lifewatch-at/LifeWatch-PCBs/LifeWatch_CO2/LifeWatch_CO2.step

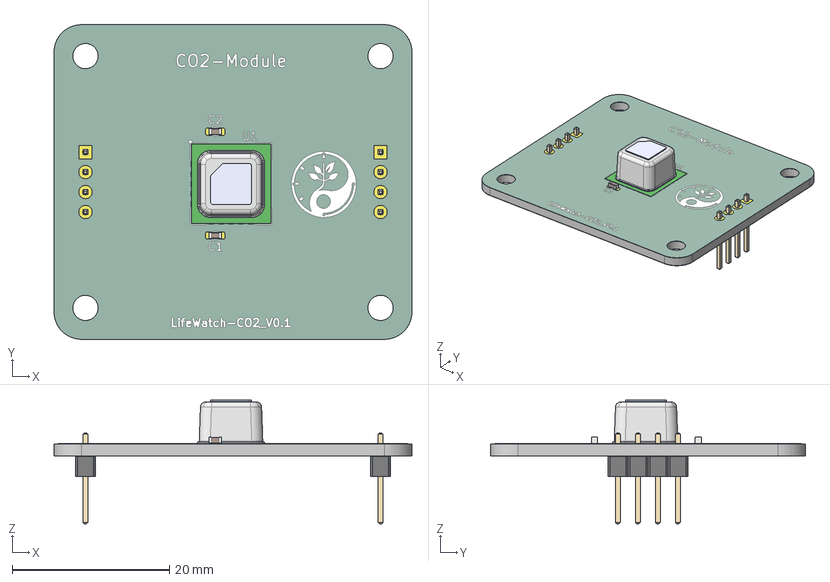
[picture p1: CAD file, 2025-07-20]
LifeWatch_CO2/LifeWatch_CO2.step
45.5 x 40.0 x 15.7 mm
C_0603_1608Metric x 2
Sensirion_CO2_Sensors_SCD4x_STEP_file
PinHeader_1x04_P2.54mm_Vertical x 2
LifeWatch_CO2_copper
LifeWatch_CO2_silkscreen
LifeWatch_CO2_soldermask
LifeWatch_CO2_PCB
