lifewatch-at/LifeWatch-PCBs/LifeWatch_MB/LifeWatch_MB.kicad_pcb

## KiCad design LifeWatch_MB/LifeWatch_MB.kicad_pcb (2025-07-20)

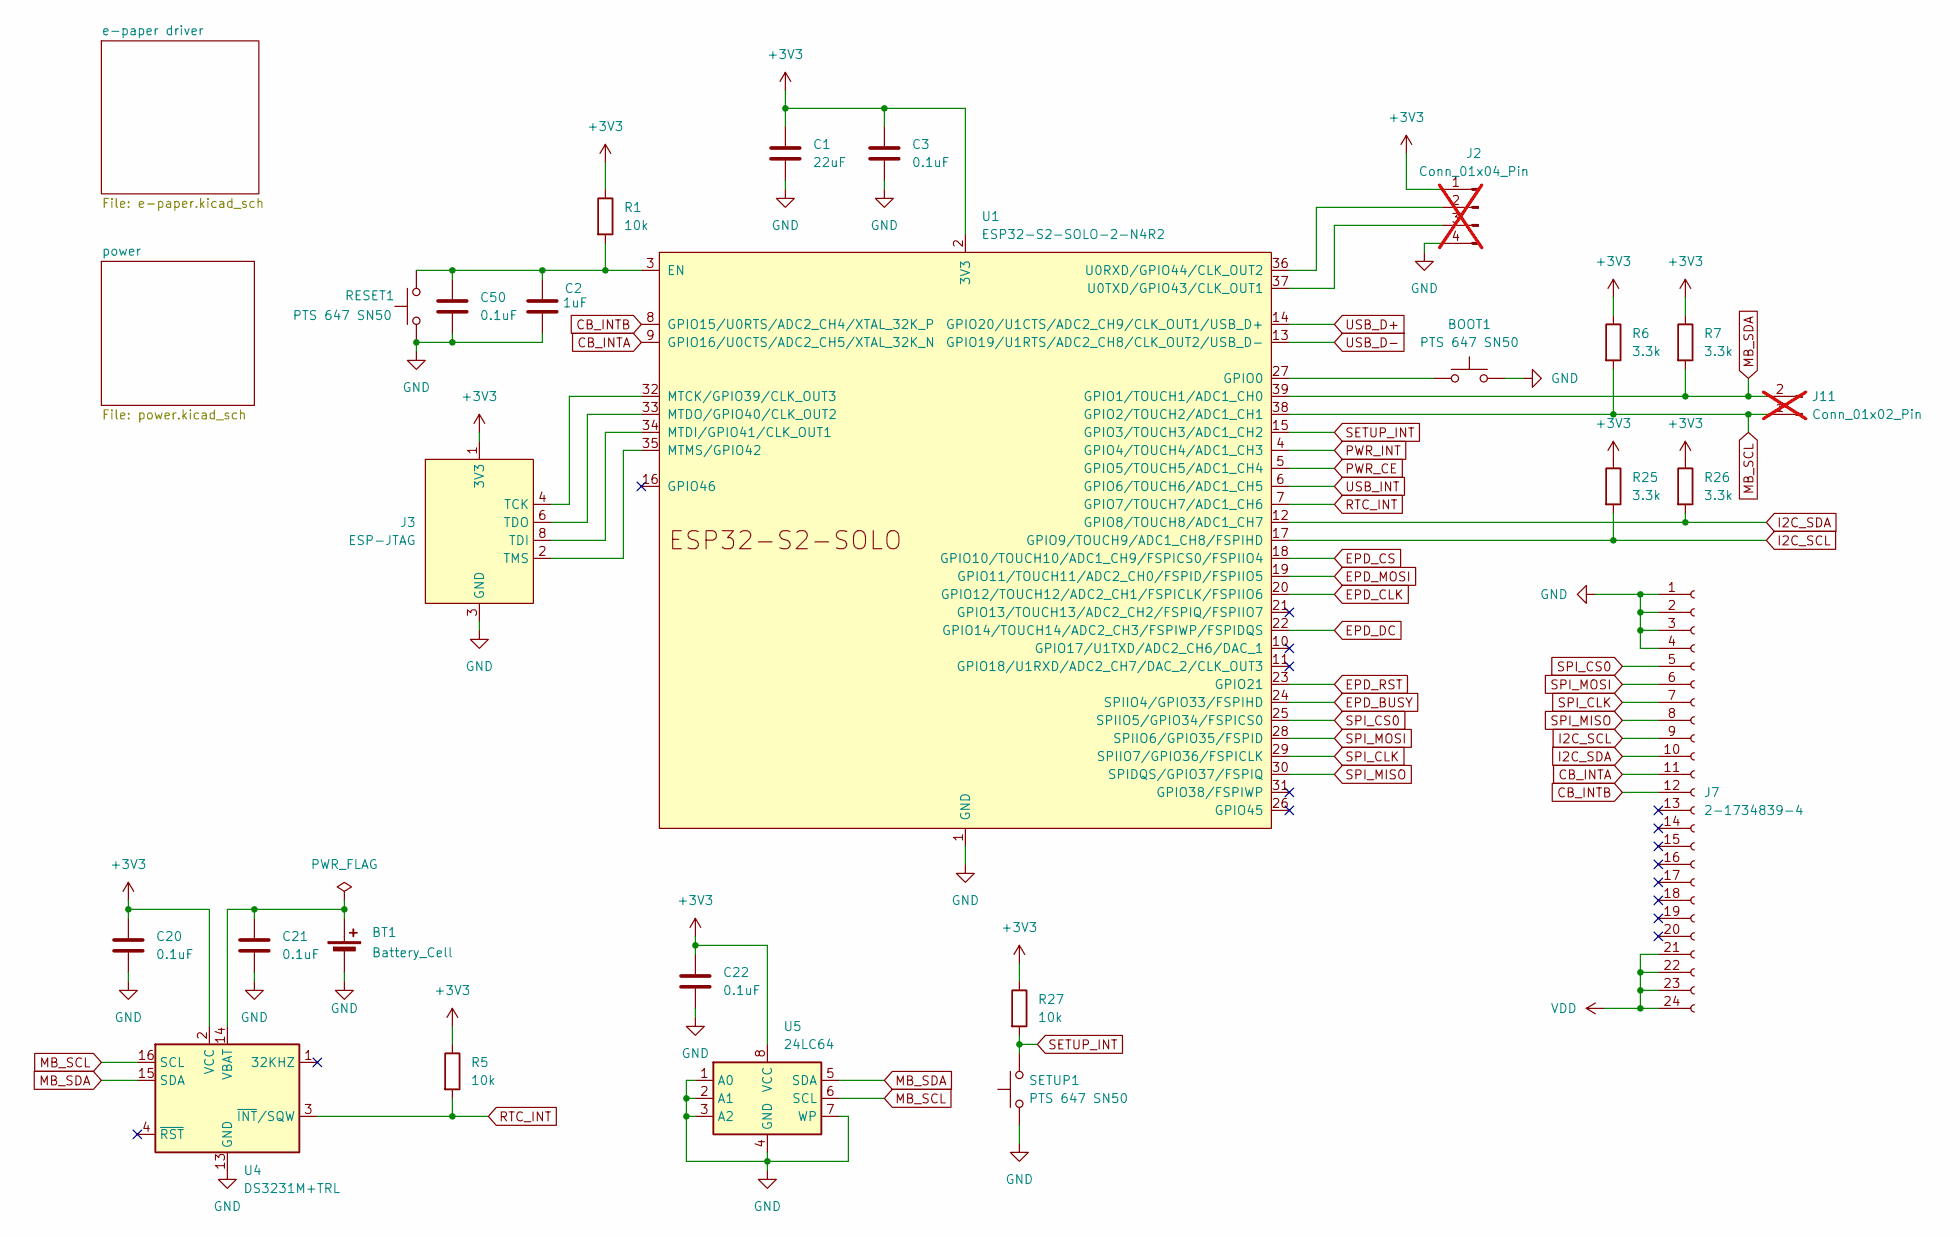
[picture p2: schematic LifeWatch_MB.kicad_sch, LifeWatch Mainboard]

Parts:
BOOT1: PTS 647 SN50; SW_SPST_PTS647_Sx50; Manufacturer_Part_Number PTS 647 SN50 SMTR2 LFS
BT1: Battery_Cell; BatteryHolder_Keystone_1060_1x2032; Manufacturer_Part_Number Keystone 3034
C1: 22uF; C_0805_2012Metric; Manufacturer_Part_Number CL21A226MQQNNNE
C2: 1uF; C_0603_1608Metric; Manufacturer_Part_Number CC0603KRX7R7BB105
C3, C20, C21, C22, C50: 0.1uF; C_0402_1005Metric; Manufacturer_Part_Number CL05B104KP5NNNC
J2: Conn_01x04_Pin; PinHeader_1x04_P2.54mm_Vertical; not fitted
J3: ESP-JTAG; IDC-Header_2x05_P2.54mm_Vertical
J7: 2-1734839-4; TE_2-1734839-4_1x24-1MP_P0.5mm_Horizontal; Manufacturer_Part_Number 2-1734839-4
J11: Conn_01x02_Pin; PinHeader_1x02_P2.54mm_Vertical; not fitted
R1, R5, R27: 10k; R_0805_2012Metric; Manufacturer_Part_Number RC0805FR-0710KL
R6, R7, R25, R26: 3.3k; R_0805_2012Metric; Manufacturer_Part_Number RC0805FR-073K3L
RESET1: PTS 647 SN50; SW_SPST_PTS647_Sx50; Manufacturer_Part_Number PTS 647 SN50 SMTR2 LFS
SETUP1: PTS 647 SN50; SW_SPST_PTS647_Sx50; Manufacturer_Part_Number PTS 647 SN50 SMTR2 LFS
U1: ESP32-S2-SOLO-2-N4R2; ESP32-S2-SOLO; Manufacturer_Part_Number ESP32-S2-SOLO-2-N4R2
U4: DS3231M+TRL; SOIC-16W_7.5x10.3mm_P1.27mm; Manufacturer_Part_Number DS3231M+TRL
U5: 24LC64; SOIC-8_3.9x4.9mm_P1.27mm; Manufacturer_Part_Number 24LC64T-I/SN

Connections:
+3V3: C1.1, C3.1, C20.1, C22.1, J2.1, J3.1 (3V3), R1.1, R5.1, R6.1, R7.1, R25.1, R26.1, R27.1, U1.2 (3V3), U4.2 (VCC), U5.8 (VCC); also elsewhere on the board
CB_INTA: J7.11, U1.9 (GPIO16/U0CTS/ADC2_CH5/XTAL_32K_N)
CB_INTB: J7.12, U1.8 (GPIO15/U0RTS/ADC2_CH4/XTAL_32K_P)
EPD_BUSY: U1.24 (SPIIO4/GPIO33/FSPIHD); also elsewhere on the board
EPD_CLK: U1.20 (GPIO12/TOUCH12/ADC2_CH1/FSPICLK/FSPIIO6); also elsewhere on the board
EPD_CS: U1.18 (GPIO10/TOUCH10/ADC1_CH9/FSPICS0/FSPIIO4); also elsewhere on the board
EPD_DC: U1.22 (GPIO14/TOUCH14/ADC2_CH3/FSPIWP/FSPIDQS); also elsewhere on the board
EPD_MOSI: U1.19 (GPIO11/TOUCH11/ADC2_CH0/FSPID/FSPIIO5); also elsewhere on the board
EPD_RST: U1.23 (GPIO21); also elsewhere on the board
GND: BOOT1.2, BT1.2 (-), C1.2, C2.2, C3.2, C20.2, C21.2, C22.2, C50.2, J2.4, J3.3 (GND), J3.5 (GND), J3.7 (GND), J3.9 (GND), J7.1, J7.2, J7.3, J7.4, RESET1.1, SETUP1.1, U1.1 (GND), U1.40 (GND), U1.41 (GND), U4.5 (GND), U4.6 (GND), U4.7 (GND), U4.8 (GND), U4.9 (GND), U4.10 (GND), U4.11 (GND), U4.12 (GND), U4.13 (GND), U5.1 (A0), U5.2 (A1), U5.3 (A2), U5.4 (GND), U5.7 (WP); also elsewhere on the board
I2C_SCL: J7.9, R25.2, U1.17 (GPIO9/TOUCH9/ADC1_CH8/FSPIHD)
I2C_SDA: J7.10, R26.2, U1.12 (GPIO8/TOUCH8/ADC1_CH7)
MB_SCL: J11.1, R6.2, U1.38 (GPIO2/TOUCH2/ADC1_CH1), U4.16 (SCL), U5.6 (SCL); also elsewhere on the board
MB_SDA: J11.2, R7.2, U1.39 (GPIO1/TOUCH1/ADC1_CH0), U4.15 (SDA), U5.5 (SDA); also elsewhere on the board
unnamed: BT1.1 (+), C21.1, U4.14 (VBAT)
unnamed: J2.2, U1.36 (U0RXD/GPIO44/CLK_OUT2)
unnamed: J2.3, U1.37 (U0TXD/GPIO43/CLK_OUT1)
unnamed: J3.4 (TCK), U1.32 (MTCK/GPIO39/CLK_OUT3)
unnamed: J3.8 (TDI), U1.34 (MTDI/GPIO41/CLK_OUT1)
unnamed: J3.6 (TDO), U1.33 (MTDO/GPIO40/CLK_OUT2)
unnamed: J3.2 (TMS), U1.35 (MTMS/GPIO42)
unnamed: C2.1, C50.1, R1.2, RESET1.2, U1.3 (EN)
unnamed: BOOT1.1, U1.27 (GPIO0)
PWR_CE: U1.5 (GPIO5/TOUCH5/ADC1_CH4); also elsewhere on the board
PWR_INT: U1.4 (GPIO4/TOUCH4/ADC1_CH3); also elsewhere on the board
RTC_INT: R5.2, U1.7 (GPIO7/TOUCH7/ADC1_CH6), U4.3 (~INT/SQW)
SETUP_INT: R27.2, SETUP1.2, U1.15 (GPIO3/TOUCH3/ADC1_CH2)
SPI_CLK: J7.7, U1.29 (SPIIO7/GPIO36/FSPICLK)
SPI_CS0: J7.5, U1.25 (SPIIO5/GPIO34/FSPICS0)
SPI_MISO: J7.8, U1.30 (SPIDQS/GPIO37/FSPIQ)
SPI_MOSI: J7.6, U1.28 (SPIIO6/GPIO35/FSPID)
USB_D+: U1.14 (GPIO20/U1CTS/ADC2_CH9/CLK_OUT1/USB_D+); also elsewhere on the board
USB_D-: U1.13 (GPIO19/U1RTS/ADC2_CH8/CLK_OUT2/USB_D-); also elsewhere on the board
USB_INT: U1.6 (GPIO6/TOUCH6/ADC1_CH5); also elsewhere on the board
VDD: J7.21, J7.22, J7.23, J7.24; also elsewhere on the board

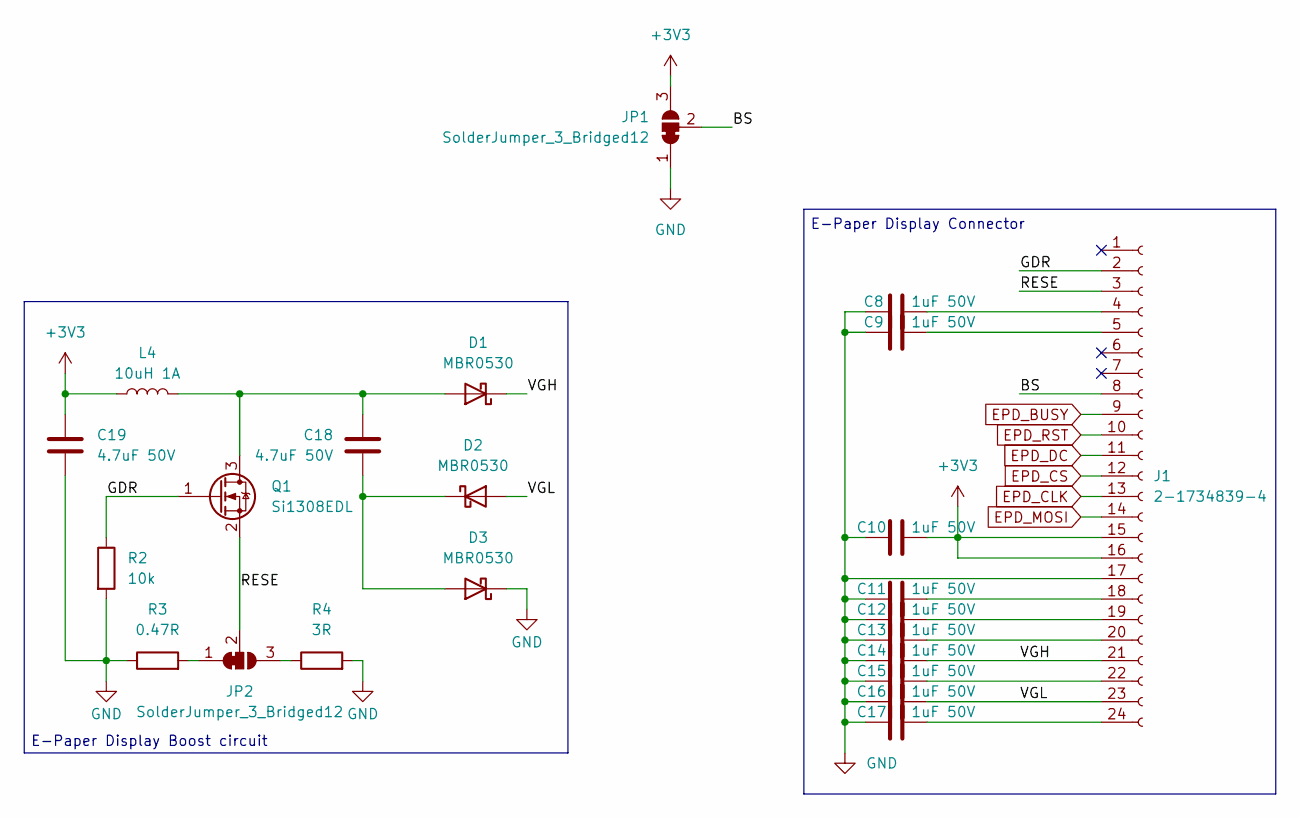
[picture p3: schematic e-paper.kicad_sch, e-paper driver]

Parts:
C8, C9, C10, C11, C12, C13, C14, C15, C16, C17: 1uF 50V; C_0805_2012Metric; Manufacturer_Part_Number CL21B105KBFNNNE
C18, C19: 4.7uF 50V; C_0805_2012Metric; Manufacturer_Part_Number GRM21BR61H475KE51L
D1, D2, D3: MBR0530; D_SOD-123; Manufacturer_Part_Number MBR0530T1G
J1: 2-1734839-4; TE_2-1734839-4_1x24-1MP_P0.5mm_Horizontal; Manufacturer_Part_Number 2-1734839-4
JP1, JP2: SolderJumper_3_Bridged12; SolderJumper-3_P1.3mm_Bridged12_RoundedPad1.0x1.5mm
L4: 10uH 1A; L_Vishay_IHLP-2525; Manufacturer_Part_Number IHLP2525CZER100M01
Q1: Si1308EDL; SOT-323_SC-70; Manufacturer_Part_Number SI1308EDL-T1-GE3
R2: 10k; R_0805_2012Metric; Manufacturer_Part_Number RC0805FR-0710KL
R3: 0.47R; R_0805_2012Metric; Manufacturer_Part_Number ERJ-6RQFR47V
R4: 3R; R_0805_2012Metric; Manufacturer_Part_Number RC0805FR-073RL

Connections:
+3V3: C10.2, C19.1, J1.15, J1.16, JP1.3 (B), L4.1; also elsewhere on the board
/e-paper driver/BS: J1.8, JP1.2 (C)
/e-paper driver/GDR: J1.2, Q1.1 (G), R2.1
/e-paper driver/RESE: J1.3, JP2.2 (C), Q1.2 (S)
/e-paper driver/VGH: C14.2, D1.1 (K), J1.21
/e-paper driver/VGL: C16.2, D2.2 (A), J1.23
EPD_BUSY: J1.9; also elsewhere on the board
EPD_CLK: J1.13; also elsewhere on the board
EPD_CS: J1.12; also elsewhere on the board
EPD_DC: J1.11; also elsewhere on the board
EPD_MOSI: J1.14; also elsewhere on the board
EPD_RST: J1.10; also elsewhere on the board
GND: C8.1, C9.1, C10.1, C11.1, C12.1, C13.1, C14.1, C15.1, C16.1, C17.1, C19.2, D3.1 (K), J1.17, JP1.1 (A), R2.2, R3.1, R4.2; also elsewhere on the board
unnamed: C18.1, D1.2 (A), L4.2, Q1.3 (D)
unnamed: C18.2, D2.1 (K), D3.2 (A)
unnamed: C8.2, J1.4
unnamed: C9.2, J1.5
unnamed: C11.2, J1.18
unnamed: C12.2, J1.19
unnamed: C13.2, J1.20
unnamed: C15.2, J1.22
unnamed: C17.2, J1.24
unnamed: JP2.1 (A), R3.2
unnamed: JP2.3 (B), R4.1

Notes on the sheet:
E-Paper Display Connector
E-Paper Display Boost circuit

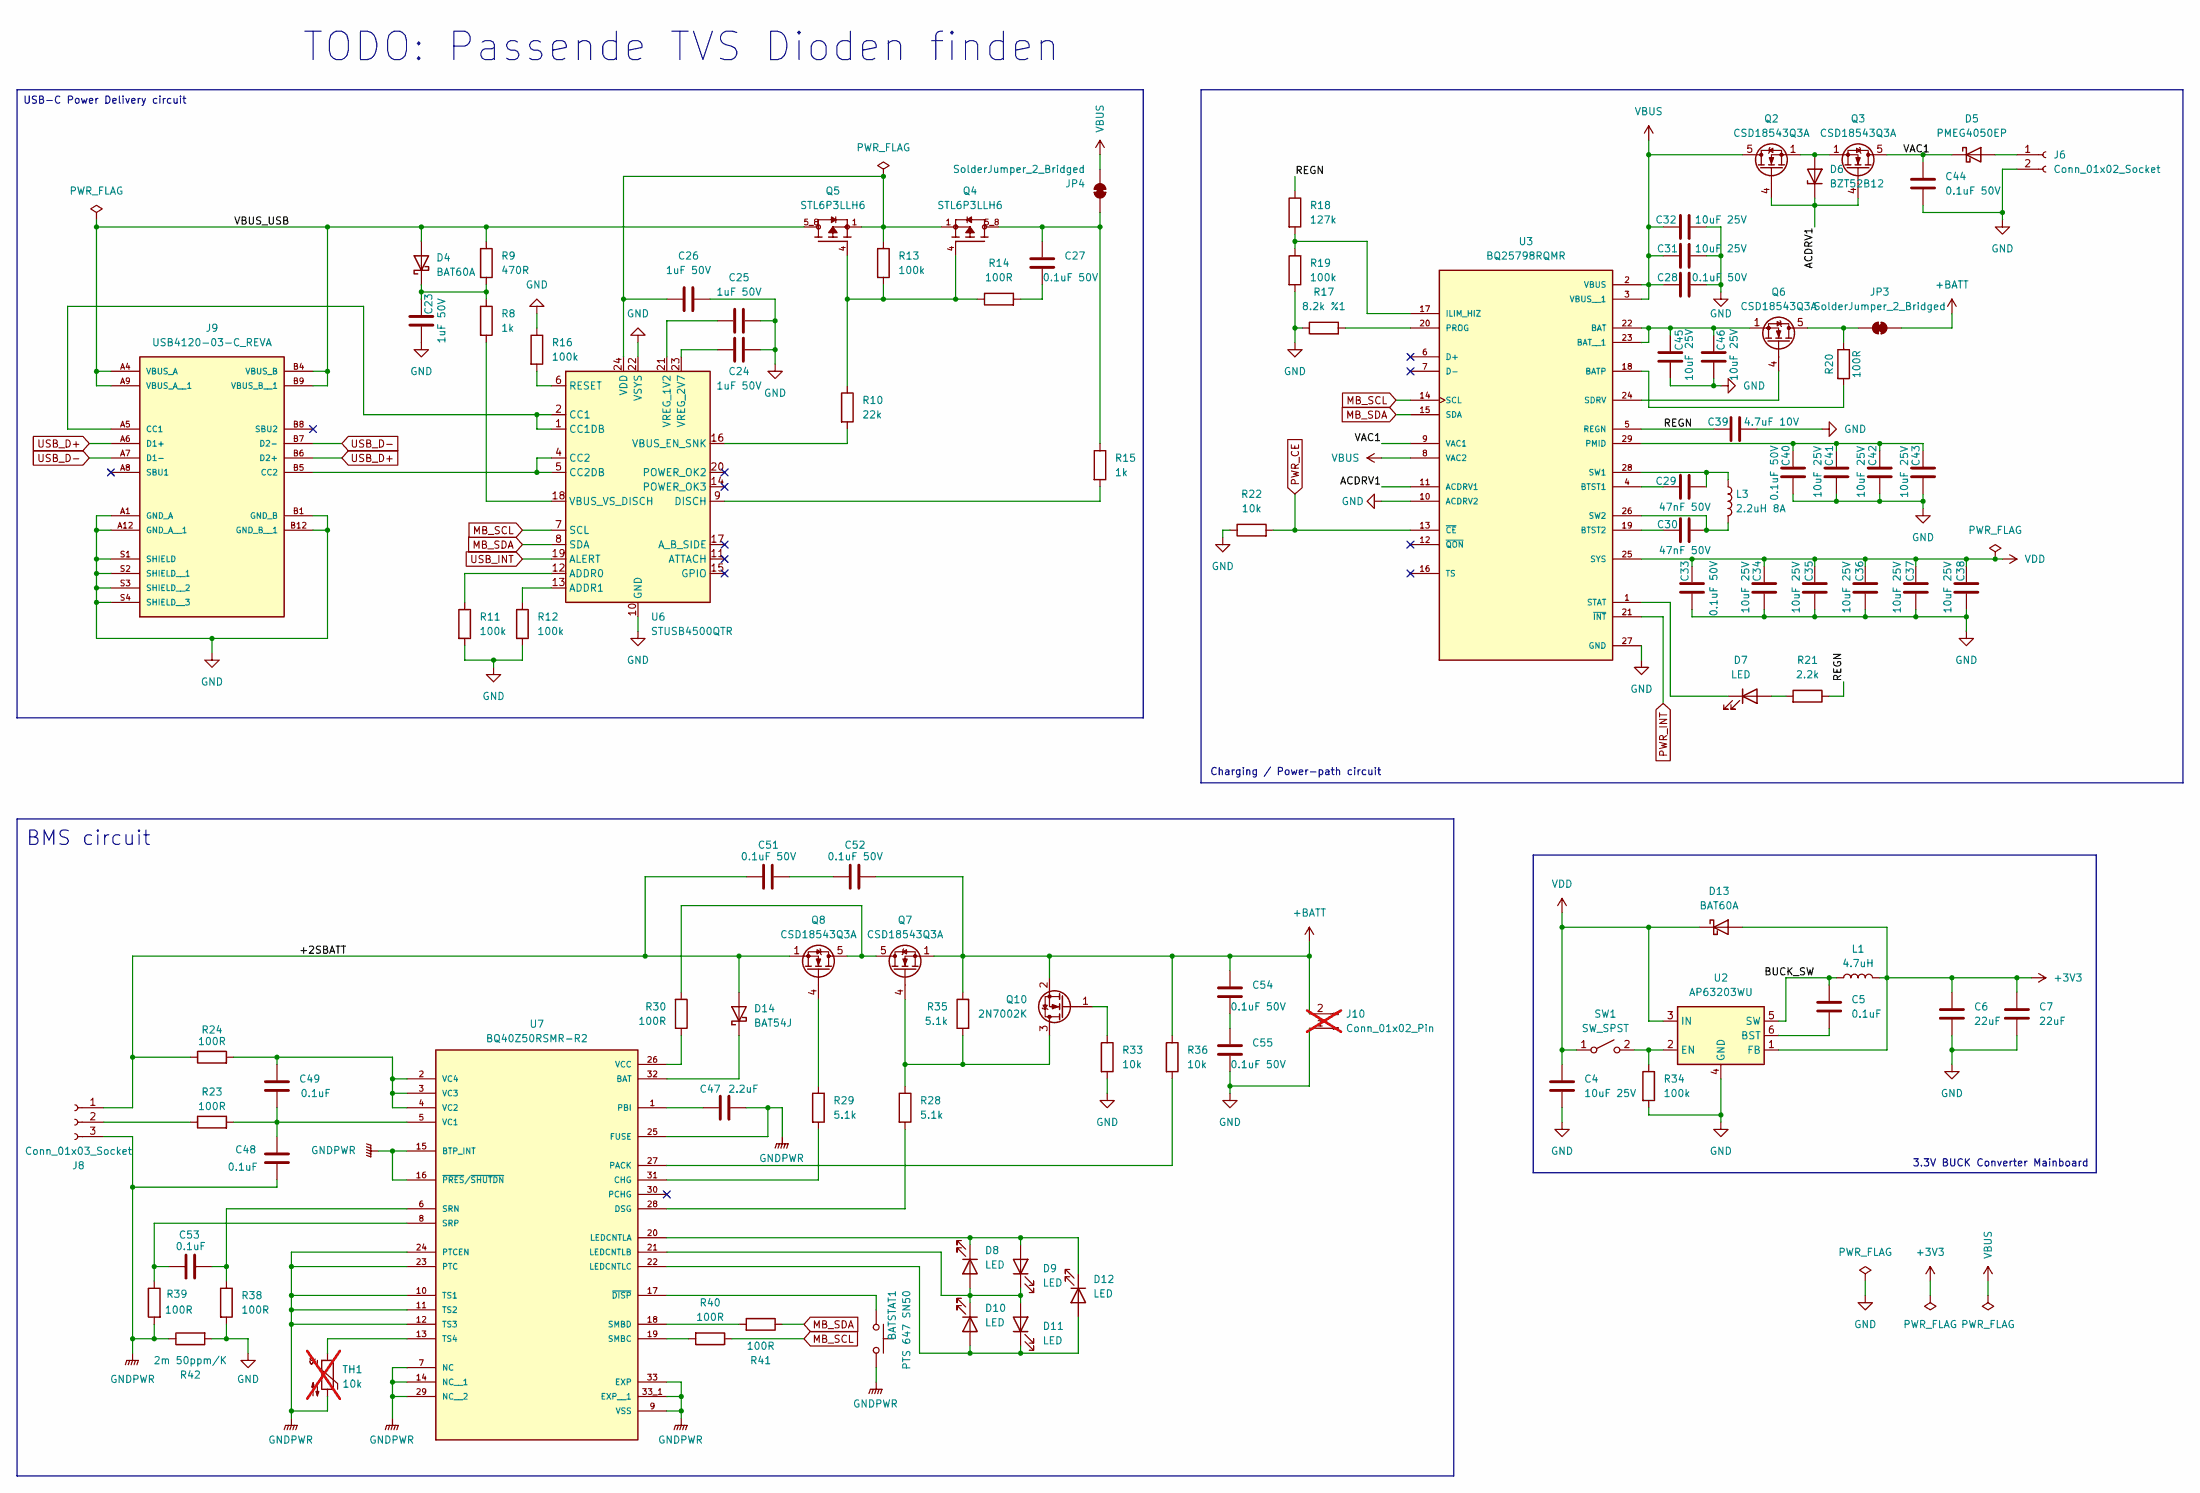
[picture p4: schematic power.kicad_sch]

Parts:
BATSTAT1: PTS 647 SN50; SW_SPST_PTS647_Sx50; Manufacturer_Part_Number PTS 647 SN50 SMTR2 LFS
C4, C31, C32, C34, C35, C36, C37, C38, C41, C42, C43, C45, C46: 10uF 25V; C_0805_2012Metric; Manufacturer_Part_Number GRM21BR61E106KA73L
C5, C48, C49, C53: 0.1uF; C_0402_1005Metric; Manufacturer_Part_Number CL05B104KP5NNNC
C6, C7: 22uF; C_0805_2012Metric; Manufacturer_Part_Number CL21A226MQQNNNE
C23, C24, C25, C26: 1uF 50V; C_0805_2012Metric; Manufacturer_Part_Number CL21B105KBFNNNE
C27, C28, C33, C40, C44, C51, C52, C54, C55: 0.1uF 50V; C_0402_1005Metric; Manufacturer_Part_Number GRM155R71H104KE14D
C29, C30: 47nF 50V; C_0402_1005Metric; Manufacturer_Part_Number CGA2B3X7R1H473K050BB
C39: 4.7uF 10V; C_0603_1608Metric; Manufacturer_Part_Number CL10A475KP8NNNC
C47: 2.2uF; C_0603_1608Metric; Manufacturer_Part_Number GRM188R71A225KE15D
D4, D13: BAT60A; D_SOD-323; Manufacturer_Part_Number BAT60AE6327HTSA1
D5: PMEG4050EP; D_SOD-128; Manufacturer_Part_Number PMEG4050EP,115
D6: BZT52B12; D_SOD-123F; Manufacturer_Part_Number BZT52C12-7-F
D7: LED; LED_D3.0mm; Manufacturer_Part_Number 150060RS75000
D8, D9, D10, D11, D12: LED; LED_0603_1608Metric; Manufacturer_Part_Number 150060RS75000
D14: BAT54J; D_SOD-323F; Manufacturer_Part_Number BAT54J,115
J6: Conn_01x02_Socket; PhoenixContact_MCV_1,5_2-GF-3.5_1x02_P3.50mm_Vertical_Threa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; Manufacturer_Part_Number 1843224
J8: Conn_01x03_Socket; JST_XH_B3B-XH-A_1x03_P2.50mm_Vertical; Manufacturer_Part_Number B3B-XH-A
J9: USB4120-03-C_REVA; GCT_USB4120-03-C_REVA; PARTREV A
J10: Conn_01x02_Pin; PinHeader_1x02_P2.54mm_Vertical; not fitted
JP3, JP4: SolderJumper_2_Bridged; SolderJumper-2_P1.3mm_Bridged_RoundedPad1.0x1.5mm
L1: 4.7uH; L_Vishay_IHLP-2525; Manufacturer_Part_Number IHLP2525CZER4R7M01
L3: 2.2uH 8A; L_Vishay_IHLP-2525; Manufacturer_Part_Number IHLP2525CZER2R2M01
Q2, Q3, Q6, Q7, Q8: CSD18543Q3A; VSON-8_3.3x3.3mm_P0.65mm_NexFET; Manufacturer_Part_Number CSD18543Q3A
Q4, Q5: STL6P3LLH6; TRANS_STL6P3LLH6; PARTREV 4
Q10: 2N7002K; SOT-23; Manufacturer_Part_Number 2N7002K
R8, R15: 1k; R_0805_2012Metric; Manufacturer_Part_Number RC0805FR-071KL
R9: 470R; R_0805_2012Metric; Manufacturer_Part_Number RC0805FR-07470RL
R10: 22k; R_0805_2012Metric; Manufacturer_Part_Number RC0805FR-0722KL
R11, R12, R13, R16, R19, R34: 100k; R_0805_2012Metric; Manufacturer_Part_Number RC0805FR-07100KL
R14, R20, R23, R24, R30, R38, R39, R40, R41: 100R; R_0805_2012Metric; Manufacturer_Part_Number RC0805FR-07100RL
R17: 8.2k %1; R_0805_2012Metric; Manufacturer_Part_Number RC0805FR-078K2L
R18: 127k; R_0805_2012Metric; Manufacturer_Part_Number RC0805FR-07127KL
R21: 2.2k; R_0805_2012Metric; Manufacturer_Part_Number RC0805FR-072K2L
R22, R33, R36: 10k; R_0805_2012Metric; Manufacturer_Part_Number RC0805FR-0710KL
R28, R29, R35: 5.1k; R_0805_2012Metric; Manufacturer_Part_Number RC0805FR-075K1L
R42: 2m 50ppm/K; R_2512_6332Metric_Pad1.40x3.35mm_HandSolder; Manufacturer_Part_Number BVT-I-R002-1.0
SW1: SW_SPST; PinHeader_1x02_P2.54mm_Horizontal
TH1: 10k; PinHeader_1x02_P2.54mm_Vertical; not fitted
U2: AP63203WU; TSOT-23-6; Manufacturer_Part_Number AP63203WU-7
U3: BQ25798RQMR; QFN40P400X400X100-29N; PARTREV 11/2019
U6: STUSB4500QTR; QFN-24-1EP_4x4mm_P0.5mm_EP2.7x2.7mm; Manufacturer_Part_Number STUSB4500QTR
U7: BQ40Z50RSMR-R2; QFN40P400X400X100-33N; PARTREV B

Connections:
+3V3: C6.1, C7.1, D13.2 (A), L1.2, U2.1 (FB); also elsewhere on the board
+BATT: C52.2, C54.1, J10.2, JP3.2 (B), Q7.1 (S), Q7.2 (S), Q7.3 (S), Q10.2 (S), R35.1, R36.1
/power/+2SBATT: C51.1, D14.2 (A), J8.1, Q8.1 (S), Q8.2 (S), Q8.3 (S), R24.1
/power/ACDRV1: D6.1 (K), Q2.4 (G), Q3.4 (G), U3.11 (ACDRV1)
/power/BUCK_SW: C5.2, L1.1, U2.5 (SW)
/power/REGN: C39.1, R18.1, R21.1, U3.5 (REGN)
/power/VAC1: C44.1, D5.1 (K), Q3.5 (D), U3.9 (VAC1)
/power/VBUS_USB: D4.2 (A), J9.A4 (VBUS_A), J9.A9 (VBUS_A__1), J9.B4 (VBUS_B), J9.B9 (VBUS_B__1), Q5.5_8, R9.1
GND: C4.2, C6.2, C7.2, C23.2, C24.2, C25.2, C26.2, C28.2, C31.2, C32.2, C33.2, C34.2, C35.2, C36.2, C37.2, C38.2, C39.2, C40.2, C41.2, C42.2, C43.2, C44.2, C45.2, C46.2, C55.2, J6.2, J9.A1 (GND_A), J9.A12 (GND_A__1), J9.B1 (GND_B), J9.B12 (GND_B__1), J9.S1 (SHIELD), J9.S2 (SHIELD__1), J9.S3 (SHIELD__2), J9.S4 (SHIELD__3), J10.1, R11.2, R12.2, R16.1, R17.1, R19.2, R22.1, R33.2, R34.2, R38.2, R42.2, U2.4 (GND), U3.10 (ACDRV2), U3.27 (GND), U6.10 (GND), U6.22 (VSYS), U6.25 (GND); also elsewhere on the board
GNDPWR: BATSTAT1.2, C47.2, C48.2, J8.3, R39.2, R42.1, TH1.2, U7.7 (NC), U7.9 (VSS), U7.10 (TS1), U7.11 (TS2), U7.12 (TS3), U7.14 (NC__1), U7.15 (BTP_INT), U7.16 (~PRES/~SHUTDN), U7.23 (PTC), U7.24 (PTCEN), U7.25 (FUSE), U7.29 (NC__2), U7.33 (EXP), U7.33_1 (EXP__1)
MB_SCL: R40.1, U3.14 (SCL), U6.7 (SCL); also elsewhere on the board
MB_SDA: R41.1, U3.15 (SDA), U6.8 (SDA); also elsewhere on the board
unnamed: C27.2, R14.2
unnamed: C51.2, C52.1
unnamed: C54.2, C55.1
unnamed: C23.1, D4.1 (K), R8.1, R9.2
unnamed: D5.2 (A), J6.1
unnamed: D6.2 (A), Q2.1 (S), Q2.2 (S), Q2.3 (S), Q3.1 (S), Q3.2 (S), Q3.3 (S)
unnamed: D7.2 (A), R21.2
unnamed: D7.1 (K), U3.1 (STAT)
unnamed: D10.2 (A), D11.1 (K), D12.2 (A), U7.22 (LEDCNTLC)
unnamed: D8.2 (A), D9.1 (K), D10.1 (K), D11.2 (A), U7.21 (LEDCNTLB)
unnamed: D8.1 (K), D9.2 (A), D12.1 (K), U7.20 (LEDCNTLA)
unnamed: D14.1 (K), U7.32 (BAT)
unnamed: J8.2, R23.1
unnamed: J9.A5 (CC1), U6.1 (CC1DB), U6.2 (CC1)
unnamed: J9.B5 (CC2), U6.4 (CC2), U6.5 (CC2DB)
unnamed: JP3.1 (A), Q6.5 (D), R20.1
unnamed: C27.1, JP4.1 (A), Q4.5_8, R15.1
unnamed: Q4.4, Q5.4, R10.1, R13.2, R14.1
unnamed: Q6.4 (G), U3.24 (SDRV)
unnamed: Q7.5 (D), Q8.5 (D), R30.2
unnamed: Q8.4 (G), R29.1
unnamed: Q7.4 (G), Q10.3 (D), R28.1, R35.2
unnamed: Q10.1 (G), R33.1
unnamed: R34.1, SW1.2 (B), U2.2 (EN)
unnamed: C5.1, U2.6 (BST)
unnamed: C45.1, C46.1, Q6.1 (S), Q6.2 (S), Q6.3 (S), U3.22 (BAT), U3.23 (BAT__1)
unnamed: R20.2, U3.18 (BATP)
unnamed: C29.1, U3.4 (BTST1)
unnamed: C30.1, U3.19 (BTST2)
unnamed: R18.2, R19.1, U3.17 (ILIM_HIZ)
unnamed: C40.1, C41.1, C42.1, C43.1, U3.29 (PMID)
unnamed: R17.2, U3.20 (PROG)
unnamed: C29.2, L3.1, U3.28 (SW1)
unnamed: C30.2, L3.2, U3.26 (SW2)
unnamed: R11.1, U6.12 (ADDR0)
unnamed: R12.1, U6.13 (ADDR1)
unnamed: R15.2, U6.9 (DISCH)
unnamed: R16.2, U6.6 (RESET)
unnamed: R10.2, U6.16 (VBUS_EN_SNK)
unnamed: R8.2, U6.18 (VBUS_VS_DISCH)
unnamed: C26.1, Q4.1, Q4.2, Q4.3, Q5.1, Q5.2, Q5.3, R13.1, U6.24 (VDD)
unnamed: C25.1, U6.21 (VREG_1V2)
unnamed: C24.1, U6.23 (VREG_2V7)
unnamed: R29.2, U7.31 (CHG)
unnamed: R28.2, U7.28 (DSG)
unnamed: R36.2, U7.27 (PACK)
unnamed: C47.1, U7.1 (PBI)
unnamed: R40.2, U7.19 (SMBC)
unnamed: R41.2, U7.18 (SMBD)
unnamed: C53.2, R38.1, U7.6 (SRN)
unnamed: C53.1, R39.1, U7.8 (SRP)
unnamed: TH1.1, U7.13 (TS4)
unnamed: C48.1, C49.2, R23.2, U7.5 (VC1)
unnamed: C49.1, R24.2, U7.2 (VC4), U7.3 (VC3), U7.4 (VC2)
unnamed: R30.1, U7.26 (VCC)
unnamed: BATSTAT1.1, U7.17 (~DISP)
PWR_CE: R22.2, U3.13 (~CE); also elsewhere on the board
PWR_INT: U3.21 (~INT); also elsewhere on the board
USB_D+: J9.A6 (D1+), J9.B6 (D2+); also elsewhere on the board
USB_D-: J9.A7 (D1-), J9.B7 (D2-); also elsewhere on the board
USB_INT: U6.19 (ALERT); also elsewhere on the board
VBUS: C28.1, C31.1, C32.1, JP4.2 (B), Q2.5 (D), U3.2 (VBUS), U3.3 (VBUS__1), U3.8 (VAC2)
VDD: C4.1, C33.1, C34.1, C35.1, C36.1, C37.1, C38.1, D13.1 (K), SW1.1 (A), U2.3 (IN), U3.25 (SYS); also elsewhere on the board

Notes on the sheet:
TODO: Passende TVS Dioden finden
USB-C Power Delivery circuit
3.3V BUCK Converter Mainboard
BMS circuit
Charging / Power-path circuit

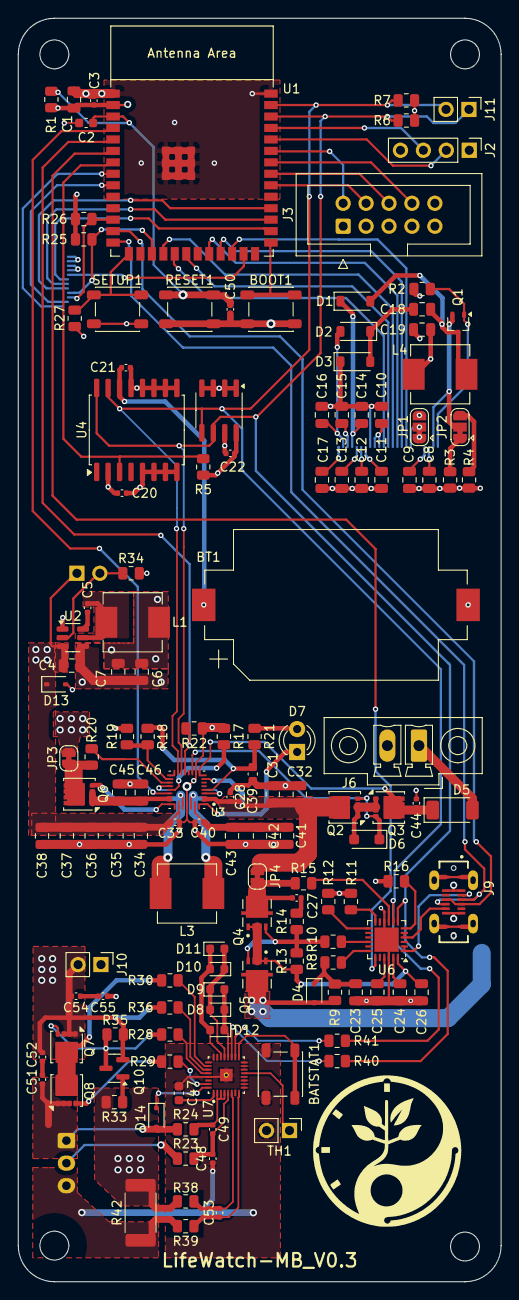
[picture p5: board LifeWatch_MB.kicad_pcb from above]

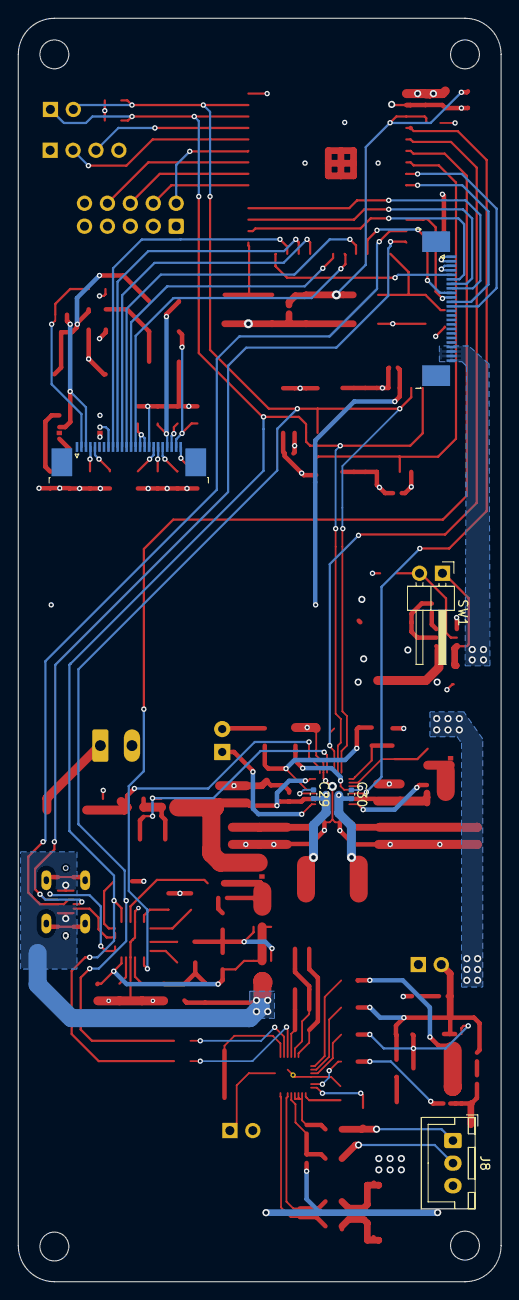
[picture p6: board LifeWatch_MB.kicad_pcb from below]

Board: 4 copper layers, 53.5 x 140.0 mm, 147 parts (6 on the bottom side), 116 nets.
