lifewatch-at/LifeWatch-PCBs/LifeWatch_Noise/LifeWatch_Noise.kicad_pcb

## KiCad design LifeWatch_Noise/LifeWatch_Noise.kicad_pcb (2025-07-20)

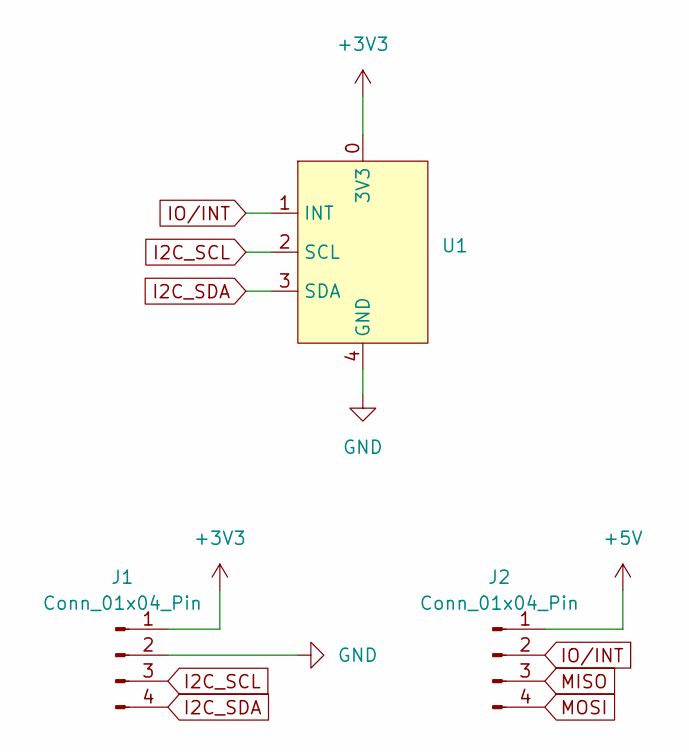
[picture p7: schematic LifeWatch_Noise.kicad_sch, LifeWatch-Noise]

Parts:
J1, J2: Conn_01x04_Pin; PinHeader_1x04_P2.54mm_Vertical
U1: i2c_decibel

Connections:
+3V3: J1.1, U1.0 (3V3)
+5V: J2.1
GND: J1.2, U1.4 (GND)
I2C_SCL: J1.3, U1.2 (SCL)
I2C_SDA: J1.4, U1.3 (SDA)
IO/INT: J2.2, U1.1 (INT)
MISO: J2.3
MOSI: J2.4

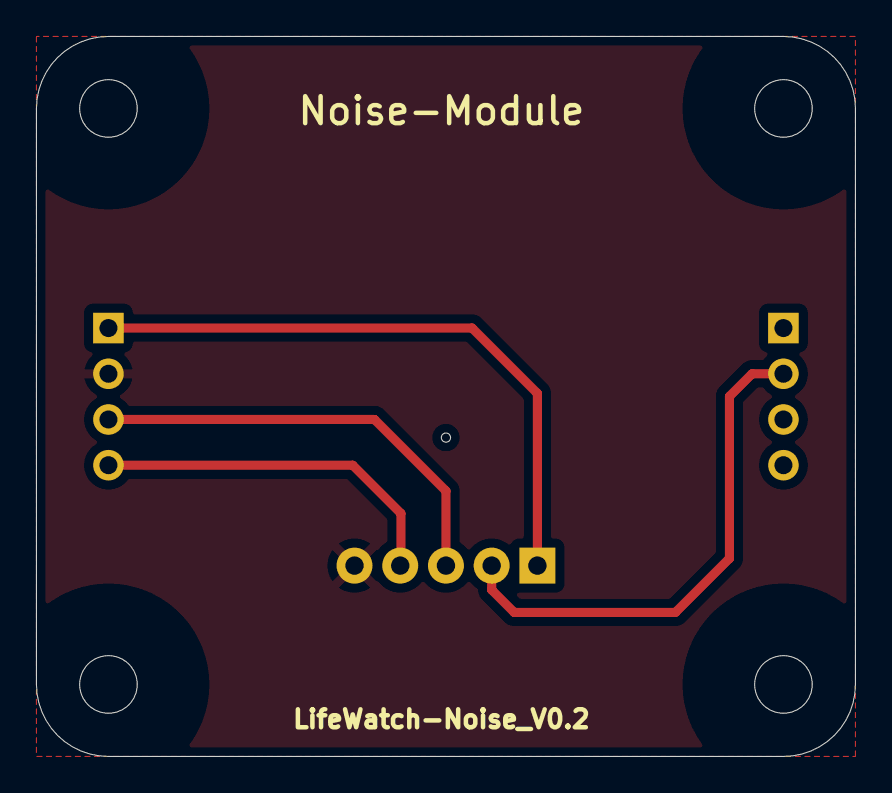
[picture p8: board LifeWatch_Noise.kicad_pcb from above]

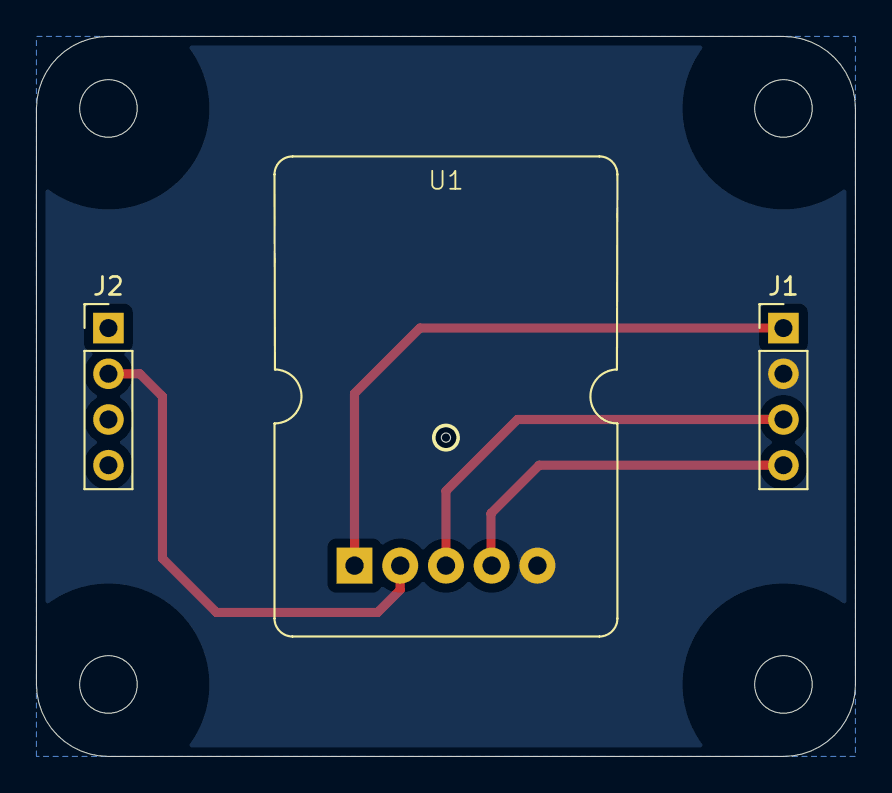
[picture p9: board LifeWatch_Noise.kicad_pcb from below]

Board: 2 copper layers, 45.5 x 40.0 mm, 3 parts (3 on the bottom side), 5 nets.
