lifewatch-at/LifeWatch-PCBs/LifeWatch_Speaker/LifeWatch_Speaker.kicad_pcb

## KiCad design LifeWatch_Speaker/LifeWatch_Speaker.kicad_pcb (2025-07-20)

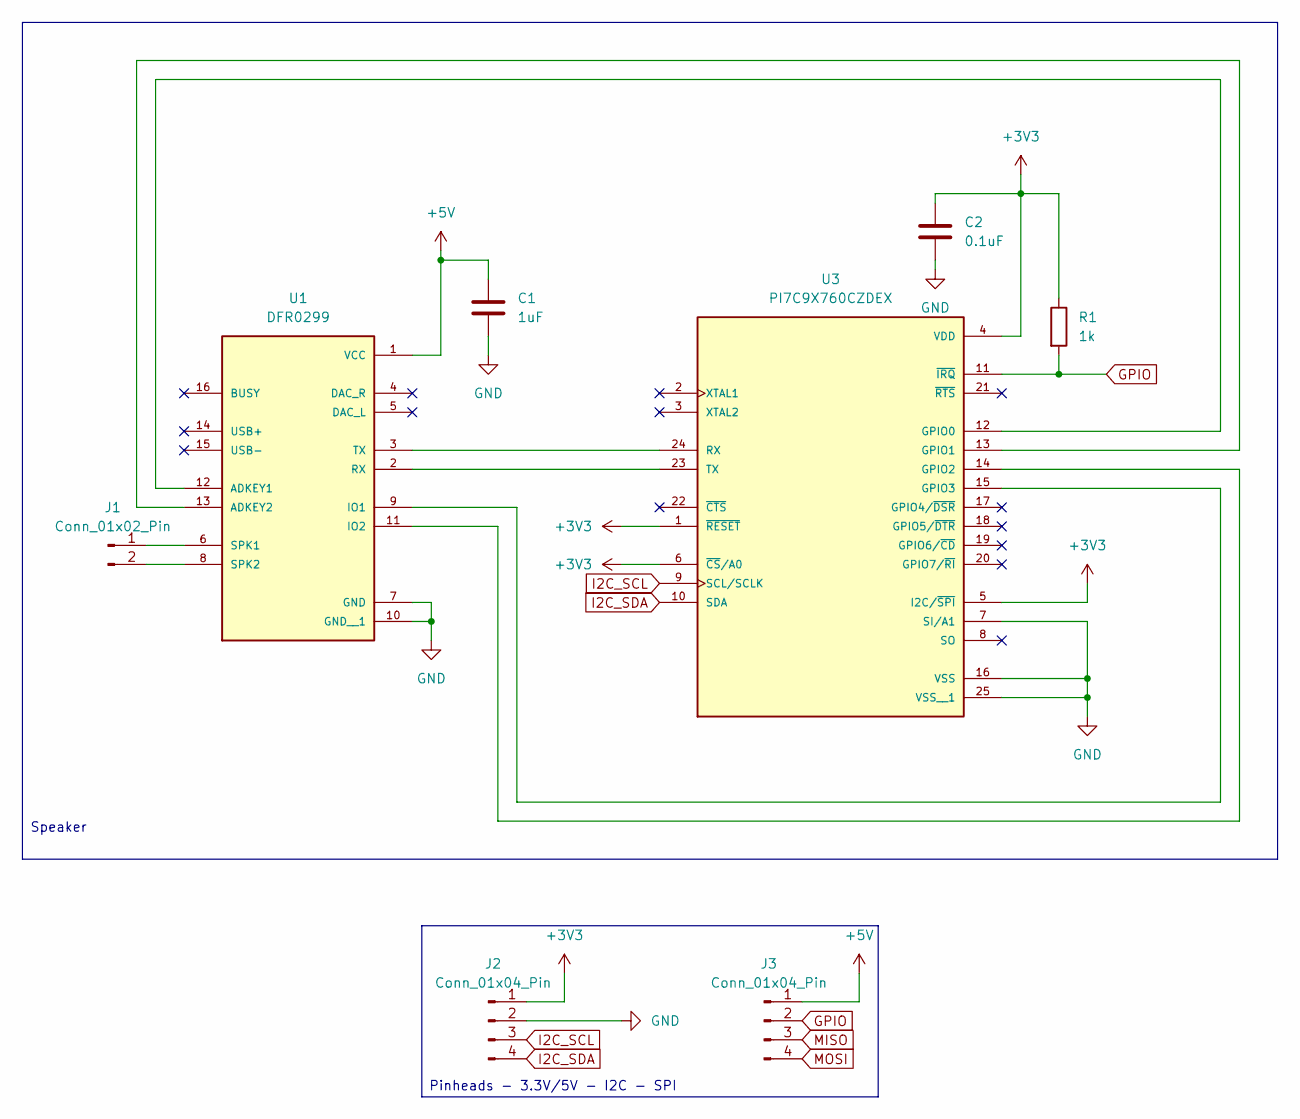
[picture p10: schematic LifeWatch_Speaker.kicad_sch, LifeWatch-Speaker]

Parts:
C1: 1uF; C_0603_1608Metric; Manufacturer_Part_Number CC0603KRX7R7BB105
C2: 0.1uF; C_0402_1005Metric; Manufacturer_Part_Number CL05B104KP5NNNC
J1: Conn_01x02_Pin; PinHeader_1x02_P2.54mm_Vertical
J2, J3: Conn_01x04_Pin; PinHeader_1x04_P2.54mm_Vertical
R1: 1k; R_0805_2012Metric; Manufacturer_Part_Number RC0805FR-071KL
U1: DFR0299; MODULE_DFR0299; Manufacturer_Part_Number DFR0299
U3: PI7C9X760CZDEX; QFN50P400X400X90-25N; PARTREV Rev 6-2

Connections:
+3V3: C2.1, J2.1, R1.1, U3.1 (~RESET), U3.4 (VDD), U3.5 (I2C/~SPI), U3.6 (~CS/A0)
+5V: C1.1, J3.1, U1.1 (VCC)
GND: C1.2, C2.2, J2.2, U1.7 (GND), U1.10 (GND__1), U3.7 (SI/A1), U3.16 (VSS), U3.25 (VSS__1)
I2C_SCL: J2.3, U3.9 (SCL/SCLK)
I2C_SDA: J2.4, U3.10 (SDA)
IO/INT: J3.2, R1.2, U3.11 (~IRQ)
MISO: J3.3
MOSI: J3.4
unnamed: J1.1, U1.6 (SPK1)
unnamed: J1.2, U1.8 (SPK2)
unnamed: U1.12 (ADKEY1), U3.12 (GPIO0)
unnamed: U1.13 (ADKEY2), U3.13 (GPIO1)
unnamed: U1.9 (IO1), U3.15 (GPIO3)
unnamed: U1.11 (IO2), U3.14 (GPIO2)
unnamed: U1.2 (RX), U3.23 (TX)
unnamed: U1.3 (TX), U3.24 (RX)

Notes on the sheet:
Pinheads - 3.3V/5V - I2C - SPI
Speaker

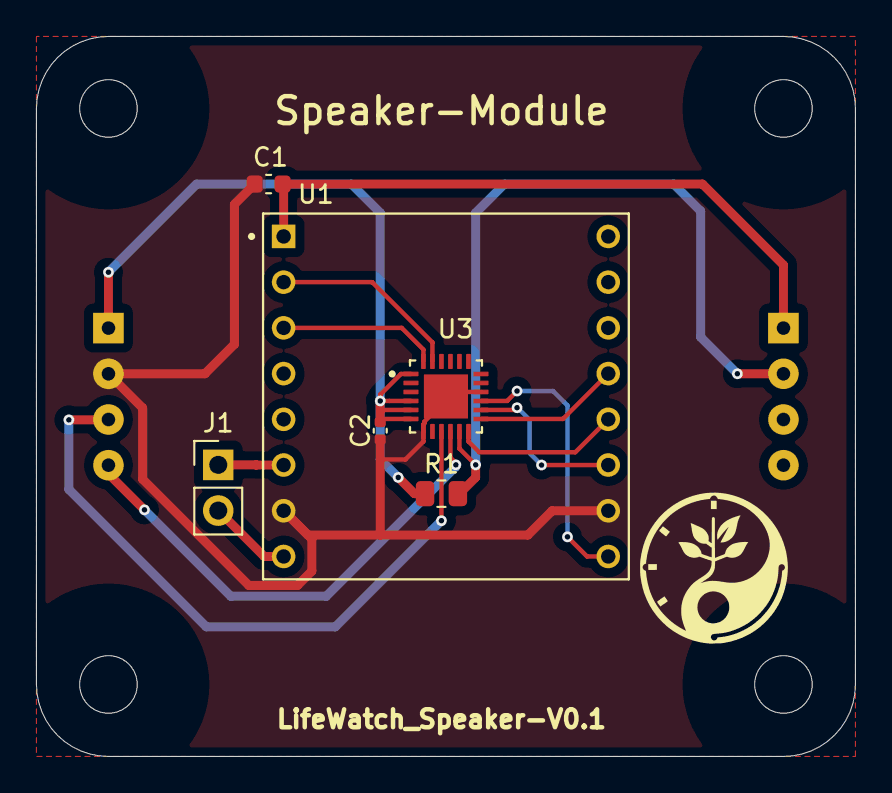
[picture p11: board LifeWatch_Speaker.kicad_pcb from above]

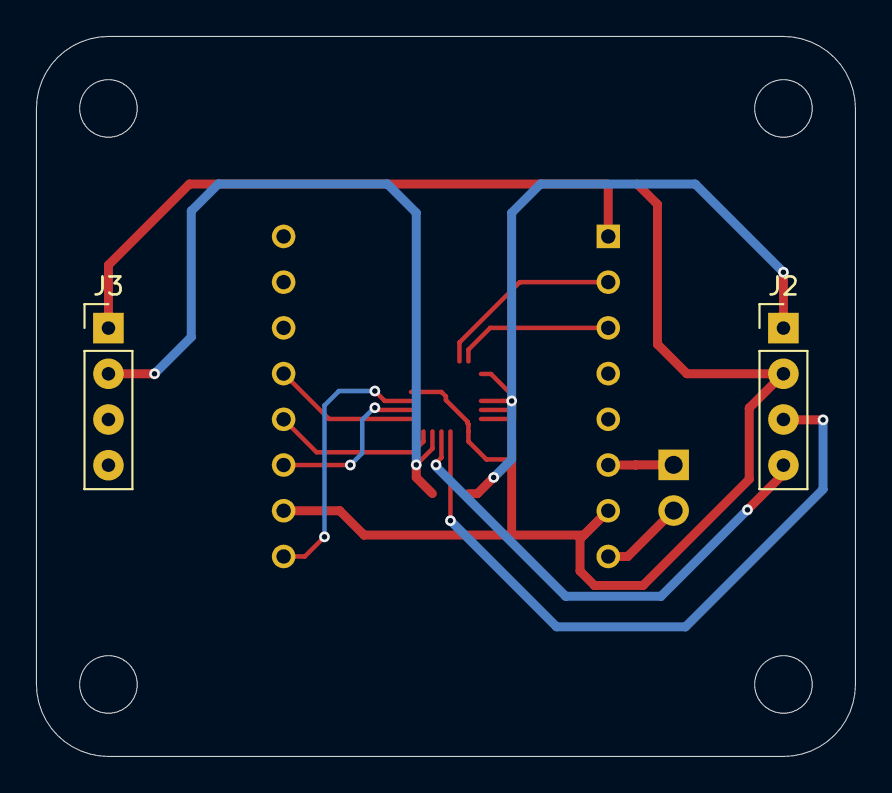
[picture p12: board LifeWatch_Speaker.kicad_pcb from below]

Board: 2 copper layers, 45.5 x 40.0 mm, 8 parts (2 on the bottom side), 14 nets.
