lifewatch-at/LifeWatch-PCBs/LifeWatch_CO/LifeWatch_CO.kicad_pcb

## KiCad design LifeWatch_CO/LifeWatch_CO.kicad_pcb (2025-07-20)

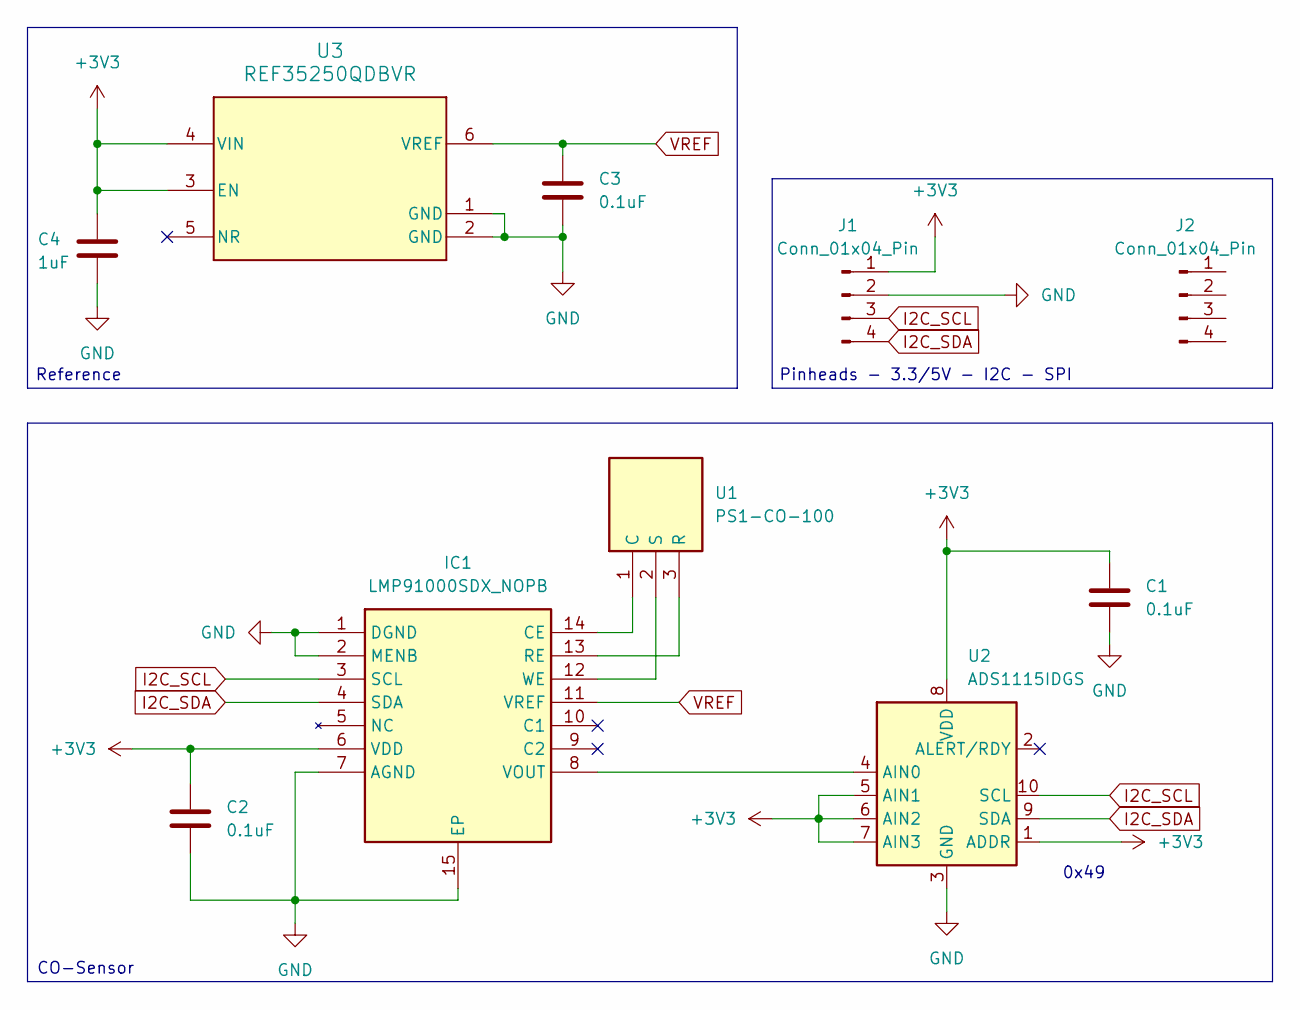
[picture p13: schematic LifeWatch_CO.kicad_sch, LifeWatch CO-Module]

Parts:
C1, C2, C3: 0.1uF; C_0402_1005Metric; Manufacturer_Part_Number CL05B104KP5NNNC
C4: 1uF; C_0603_1608Metric; Manufacturer_Part_Number CC0603KRX7R7BB105
IC1: LMP91000SDX_NOPB; WSON-14-1EP_4.0x4.0mm_P0.5mm_EP2.6x2.6mm; Mouser Part Number 926-LMP91000SDX/NOPB
J1, J2: Conn_01x04_Pin; PinHeader_1x04_P2.54mm_Vertical
U1: PS1-CO-100; PS1CO100; Mouser Part Number 523-PS1-CO-1000
U2: ADS1115IDGS; TSSOP-10_3x3mm_P0.5mm; Manufacturer_Part_Number ADS1115IDGSR
U3: REF35250QDBVR; DBV0006A-IPC_A; Manufacturer_Part_Number REF35250QDBVR

Connections:
+3V3: C1.1, C2.1, C4.1, IC1.6 (VDD), J1.1, U2.1 (ADDR), U2.5 (AIN1), U2.6 (AIN2), U2.7 (AIN3), U2.8 (VDD), U3.3 (EN), U3.4 (VIN)
GND: C1.2, C2.2, C3.2, C4.2, IC1.1 (DGND), IC1.2 (MENB), IC1.7 (AGND), IC1.15 (EP), J1.2, U2.3 (GND), U3.1 (GND), U3.2 (GND)
I2C_SCL: IC1.3 (SCL), J1.3, U2.10 (SCL)
I2C_SDA: IC1.4 (SDA), J1.4, U2.9 (SDA)
unnamed: IC1.14 (CE), U1.1 (C)
unnamed: IC1.13 (RE), U1.3 (R)
unnamed: IC1.8 (VOUT), U2.4 (AIN0)
unnamed: C3.1, IC1.11 (VREF), U3.6 (VREF)
unnamed: IC1.12 (WE), U1.2 (S)

Notes on the sheet:
Reference
0x49
Pinheads - 3.3/5V - I2C - SPI
CO-Sensor

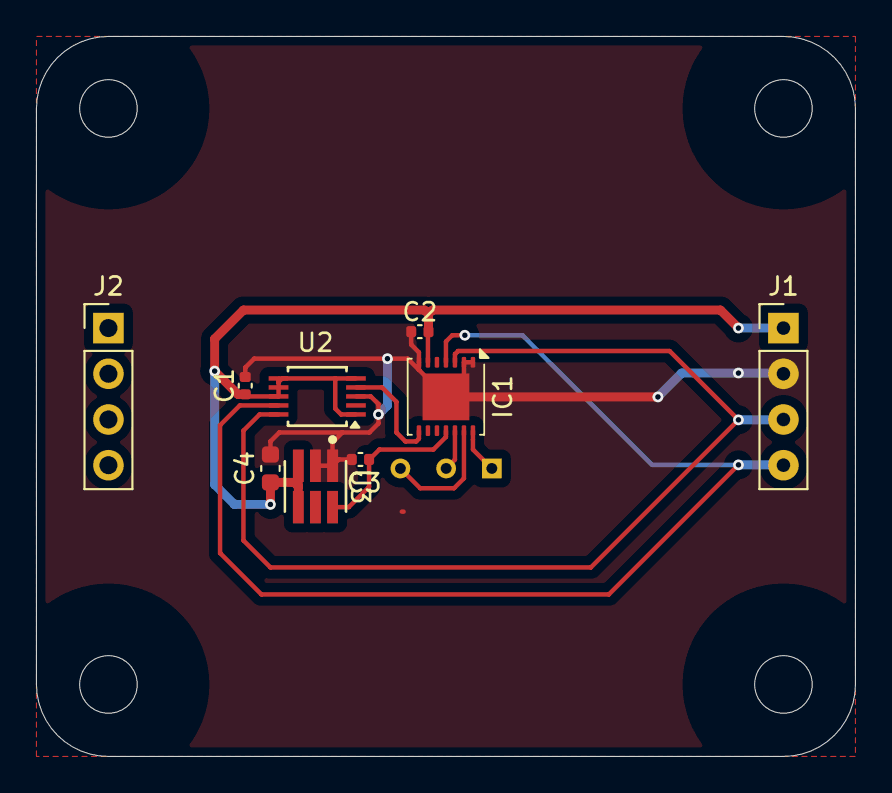
[picture p14: board LifeWatch_CO.kicad_pcb from above]

Board: 2 copper layers, 45.5 x 40.0 mm, 10 parts (1 on the bottom side), 9 nets.
