lifewatch-at/LifeWatch-PCBs/LifeWatch_Temp/LifeWatch_Temp.kicad_pcb

## KiCad design LifeWatch_Temp/LifeWatch_Temp.kicad_pcb (2025-07-20)

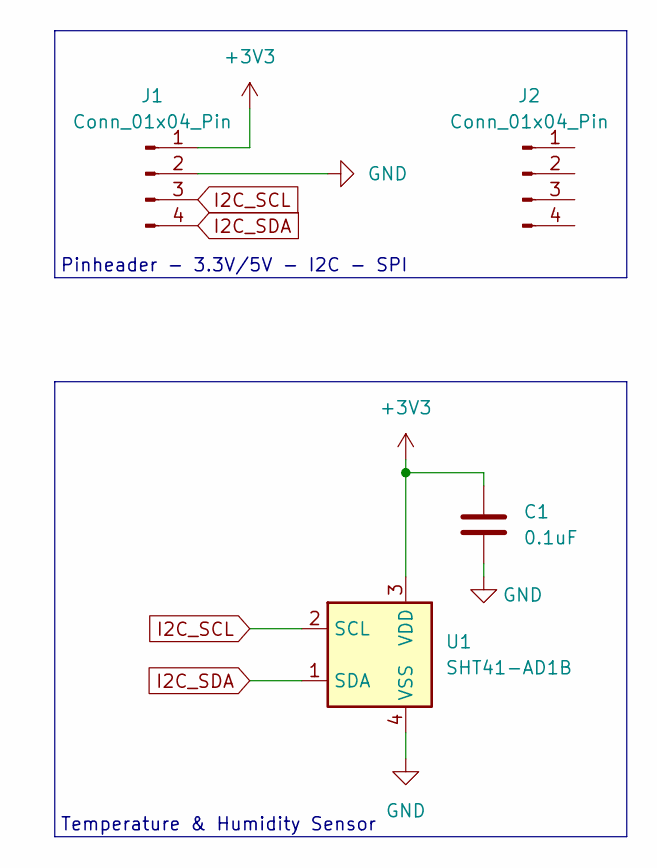
[picture p15: schematic LifeWatch_Temp.kicad_sch, LifeWatch-Temp]

Parts:
C1: 0.1uF; C_0402_1005Metric; Manufacturer_Part_Number CL05B104KP5NNNC
J1, J2: Conn_01x04_Pin; PinHeader_1x04_P2.54mm_Vertical
U1: SHT41-AD1B; Sensirion_DFN-4_1.5x1.5mm_P0.8mm_SHT4x_NoCentralPad; Manufacturer_Part_Number SHT41-AD1B

Connections:
+3V3: C1.1, J1.1, U1.3 (VDD)
GND: C1.2, J1.2, U1.4 (VSS)
I2C_SCL: J1.3, U1.2 (SCL)
I2C_SDA: J1.4, U1.1 (SDA)

Notes on the sheet:
Pinheader - 3.3V/5V - I2C - SPI
Temperature & Humidity Sensor

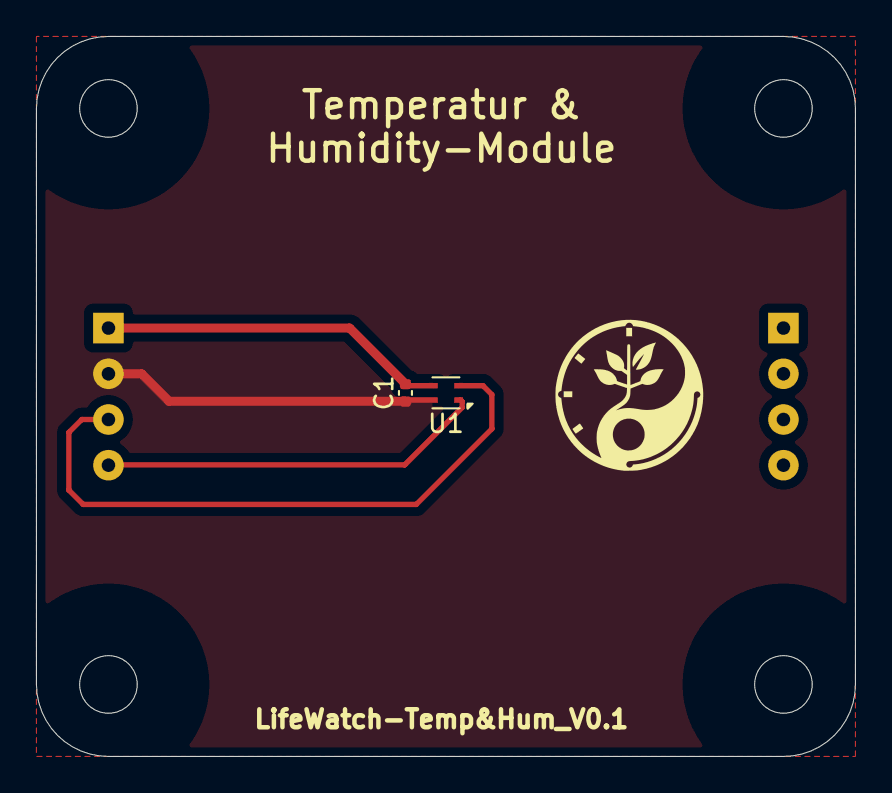
[picture p16: board LifeWatch_Temp.kicad_pcb from above]

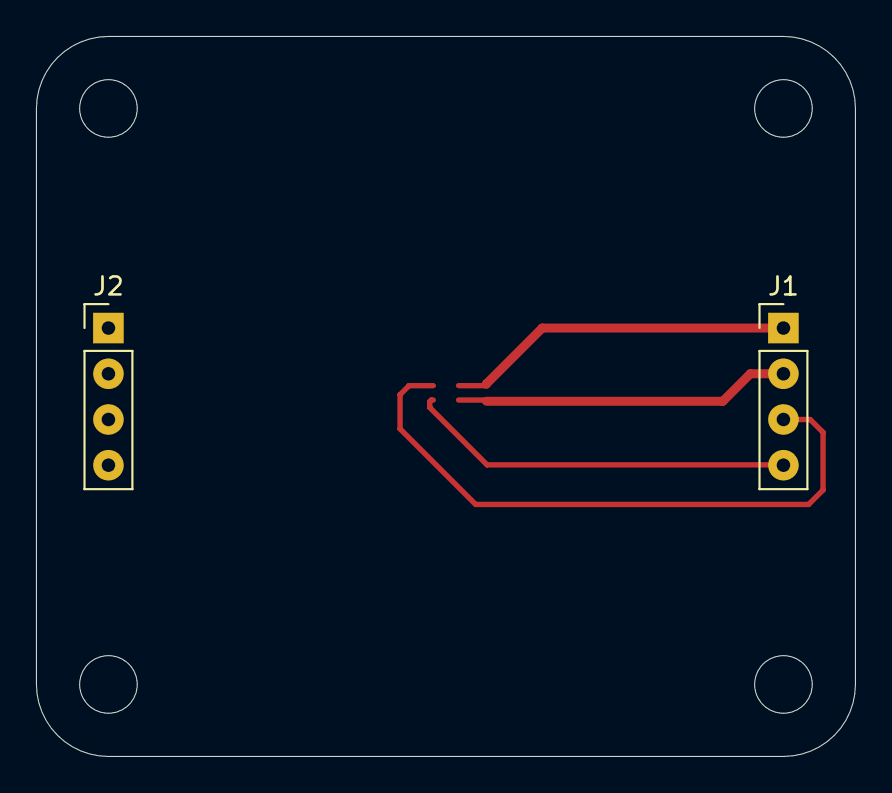
[picture p17: board LifeWatch_Temp.kicad_pcb from below]

Board: 2 copper layers, 45.5 x 40.0 mm, 4 parts (2 on the bottom side), 4 nets.
