lifewatch-at/LifeWatch-PCBs/LifeWatch_CO2/LifeWatch_CO2.kicad_pcb

## KiCad design LifeWatch_CO2/LifeWatch_CO2.kicad_pcb (2025-07-20)

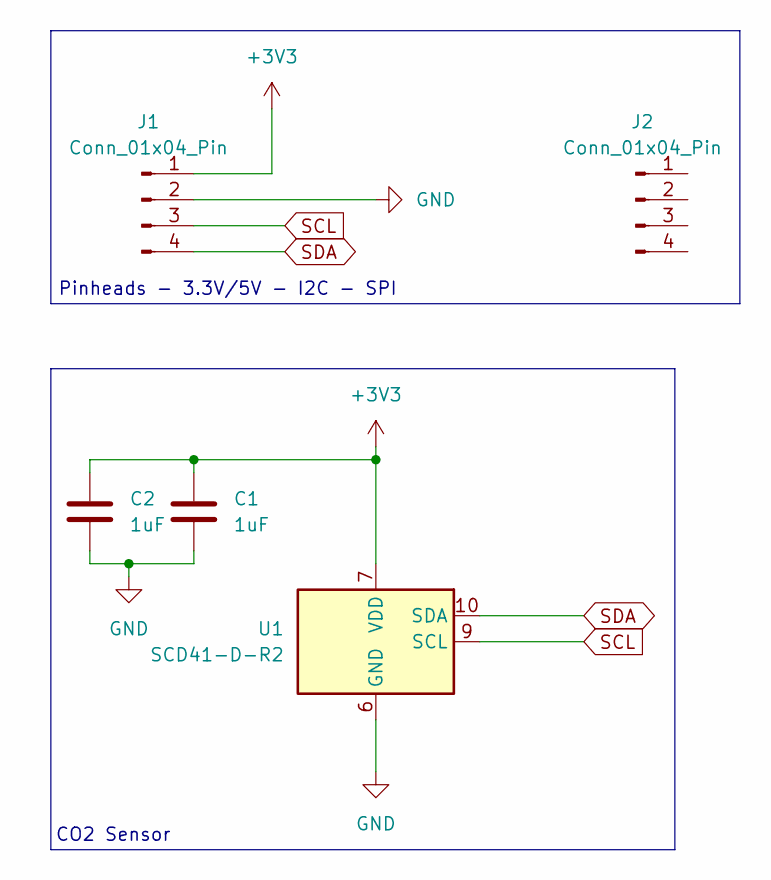
[picture p18: schematic LifeWatch_CO2.kicad_sch, LifeWatch CO2-Module]

Parts:
C1, C2: 1uF; C_0603_1608Metric; Manufacturer_Part_Name CC0603KRX7R7BB105
J1, J2: Conn_01x04_Pin; PinHeader_1x04_P2.54mm_Vertical
U1: SCD41-D-R2; Sensirion_SCD4x-1EP_10.1x10.1mm_P1.25mm_EP4.8x4.8mm; Manufacturer_Part_Name SCD-41

Connections:
+3V3: C1.1, C2.1, J1.1, U1.7 (VDD), U1.19 (VDD)
GND: C1.2, C2.2, J1.2, U1.6 (GND), U1.20 (GND), U1.21 (GND)
SCL: J1.3, U1.9 (SCL)
SDA: J1.4, U1.10 (SDA)

Notes on the sheet:
Pinheads - 3.3V/5V - I2C - SPI
CO2 Sensor

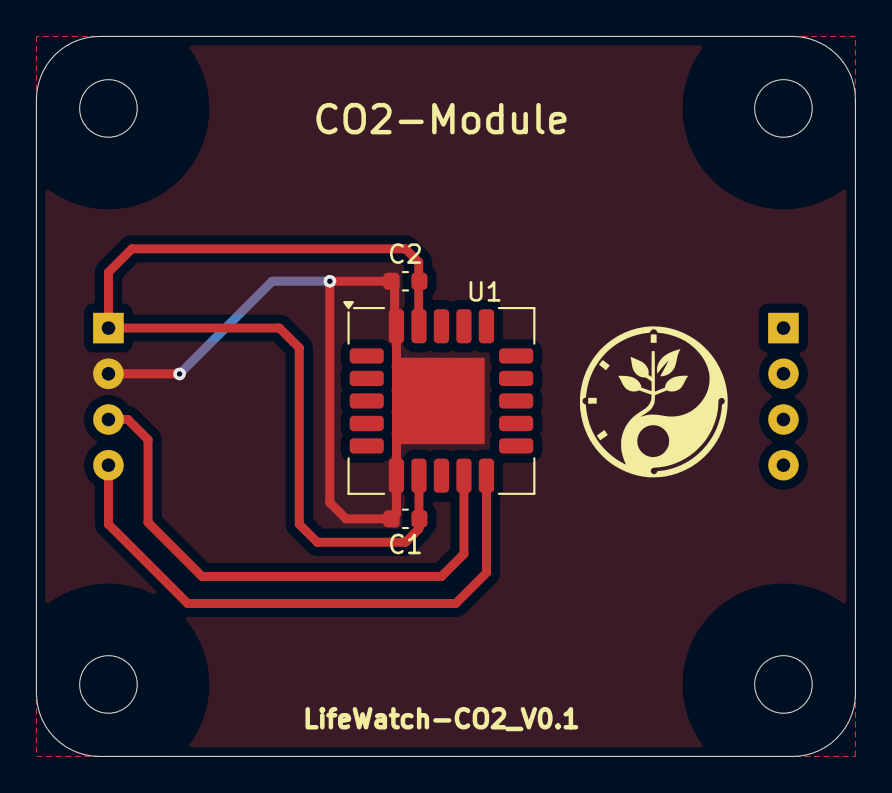
[picture p19: board LifeWatch_CO2.kicad_pcb from above]

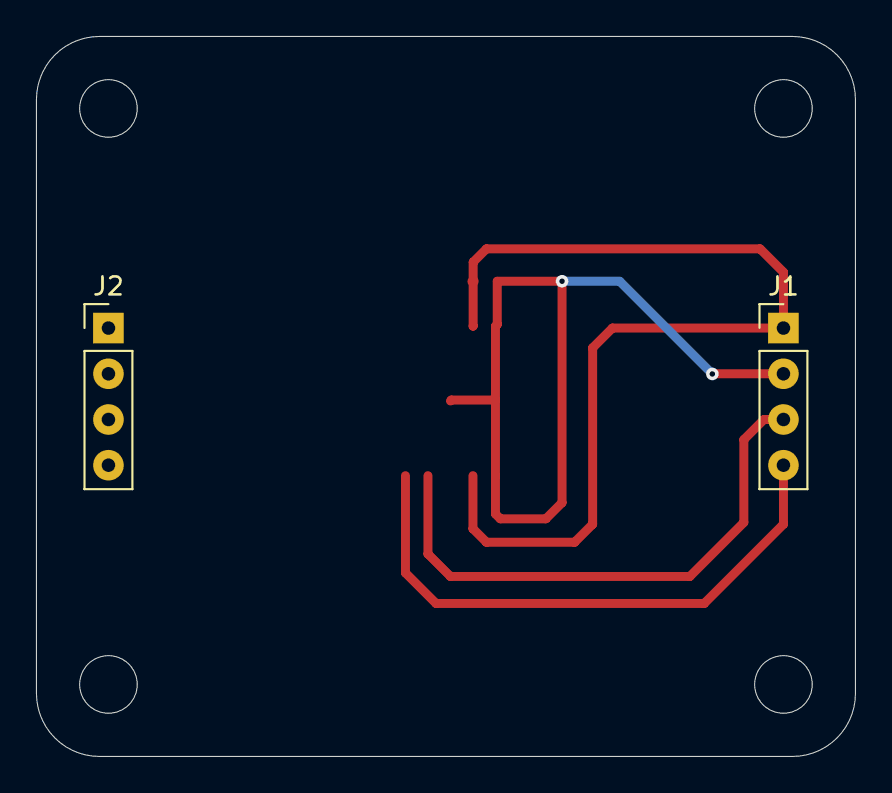
[picture p20: board LifeWatch_CO2.kicad_pcb from below]

Board: 2 copper layers, 45.5 x 40.0 mm, 5 parts (2 on the bottom side), 4 nets.
